al177/esp_hat/esp_hat.png

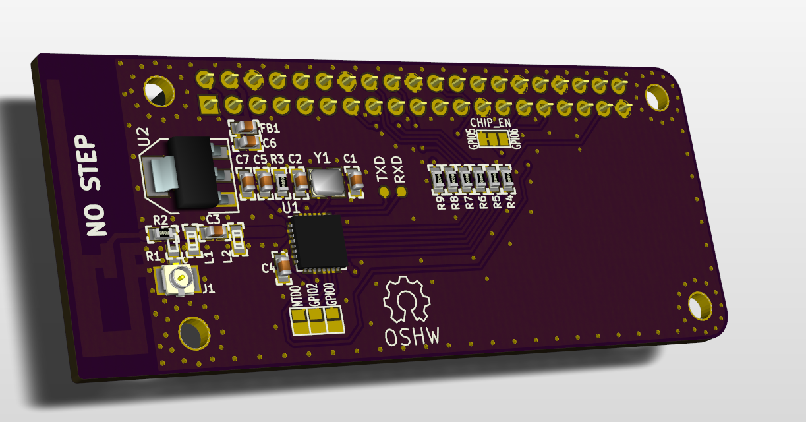
esp_hat.png
