al177/esp_hat/README.md

Attributions:
http://github.com/mcuos/kicad-lib - various footprints
https://github.com/StefanHamminga/SH_Antennas.pretty - antenna
