al177/esp_hat/esp_hat.pdf

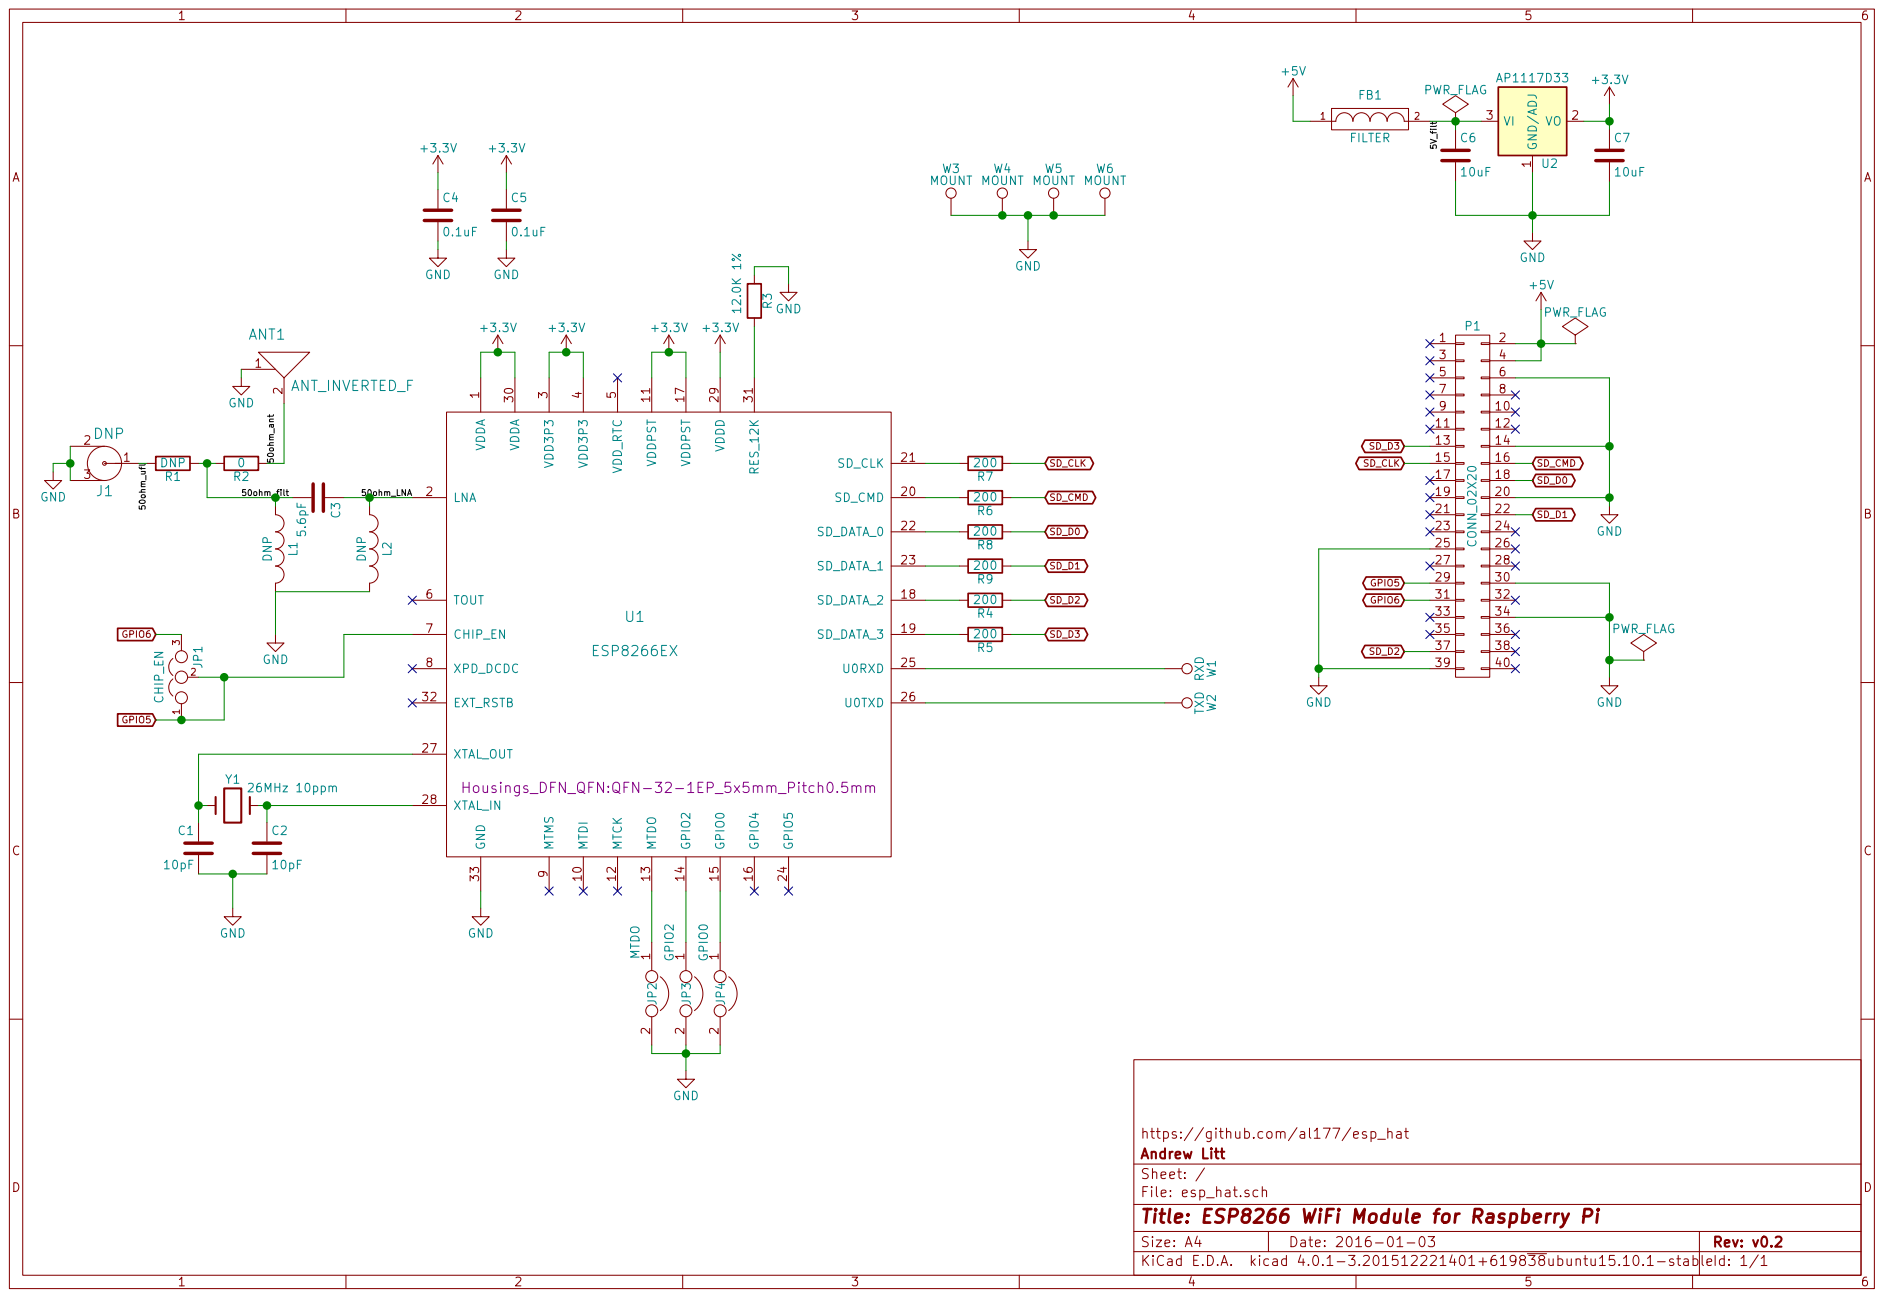
[picture p2: page 1]

9 MTDI 10 SD_CMD 20 VDDA 30 VDDPST 11 SD_CLK 21 RES_12K 31 MTCK 12 SD_DATA_0 22 EXT_RSTB 32 MTDO 13 SD_DATA_1 23 GND 33 GPIO2 14 GPIO5 24 GPIO0 15 U0RXD 25 GPIO4 16 U0TXD 26 VDDPST 17 XTAL_OUT 27 SD_DATA_2 18 XTAL_IN 28 SD_DATA_3 19 VDDD 29 U1 ESP8266EX

File: esp_hat.sch Sheet: / Andrew Litt https://github.com/al177/esp_hat

Id: 1/1 Title: ESP8266 WiFi Module for Raspberry Pi
