al177/esp_hat/esp_hat.kicad_pcb

## KiCad design esp_hat.kicad_pcb (2016-01-04)

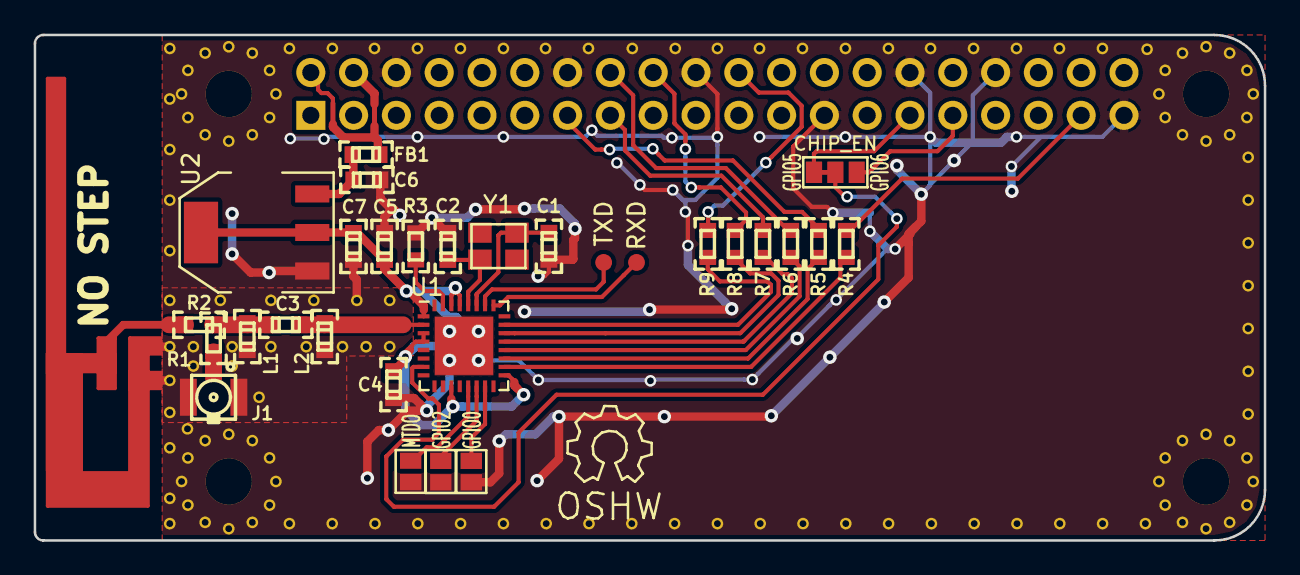
[picture p3: board esp_hat.kicad_pcb from above]

Board: 2 copper layers, 73.0 x 30.0 mm, 35 parts (1 on the bottom side), 30 nets.

Parts:
ANT1: ANT_INVERTED_F; TI_DN007_2.4GHz
C1, C2: 10pF; 0603(1608m)-CHIP-CAP
C3: 5.6pF; 0603(1608m)-CHIP-CAP
C4, C5: 0.1uF; 0603(1608m)-CHIP-CAP
C6, C7: 10uF; 0603(1608m)-CHIP-CAP
FB1: FILTER; 0603(1608m)-CHIP-CAP
J1: DNP; U.FL-COAX
JP1: CHIP_EN; GS3
JP2: MTDO; GS2
JP3: GPIO2; GS2
JP4: GPIO0; GS2
L1, L2: DNP; 0603(1608m)-CHIP-CAP
P1: CONN_02X20; Socket_Strip_Straight_2x20_pi
R1: DNP; 0603(1608m)-CHIP-RESISTOR
R2: 0; 0603(1608m)-CHIP-RESISTOR
R3: 12.0K 1%; 0603(1608m)-CHIP-RESISTOR
R4, R5, R6, R7, R8, R9: 200; 0603(1608m)-CHIP-RESISTOR
U1: ESP8266EX; QFN-32-1EP_5x5mm_Pitch0.5mm
U2: AP1117D33; SOT-223-REG_VOUTSLUG
W1: RXD; Measurement_Point_Round-SMD-Pad_Small
W2: TXD; Measurement_Point_Round-SMD-Pad_Small
W3, W4, W5, W6: MOUNT; NPTH_Hole_2_75mm
Y1: 26MHz 10ppm; crystal_FA238-TSX3225

Connections:
+3V3: C4.1, C5.1, C7.1, U1.1, U1.3, U1.4, U1.11, U1.17, U1.29, U1.30, U2.2
+5V: FB1.1, P1.2, P1.4
/5V_filt: C6.1, FB1.2, U2.3
/50ohm_LNA: C3.1, L2.1, U1.2
/50ohm_ant: ANT1.2, R2.1
/50ohm_filt: C3.2, L1.1, R1.1, R2.2
/50ohm_ufl: J1.1, R1.2
GND: ANT1.1, C1.2, C2.2, C4.2, C5.2, C6.2, C7.2, J1.2, J1.3, JP2.2, JP3.2, JP4.2, L1.2, L2.2, P1.6, P1.14, P1.20, P1.25, P1.30, P1.34, P1.39, R3.1, U1.33, U2.1, W3.1, W4.1, W5.1, W6.1
GPIO5: JP1.1, JP1.2, P1.29, U1.7
GPIO6: JP1.3, P1.31
unnamed: C1.1, U1.27, Y1.1
unnamed: C2.1, U1.28, Y1.2
unnamed: JP2.1, U1.13
unnamed: JP3.1, U1.14
unnamed: JP4.1, U1.15
unnamed: R3.2, U1.31
unnamed: R4.2, U1.18
unnamed: R5.2, U1.19
unnamed: R6.2, U1.20
unnamed: R7.2, U1.21
unnamed: R8.2, U1.22
unnamed: R9.2, U1.23
unnamed: U1.25, W1.1
unnamed: U1.26, W2.1
SD_CLK: P1.15, R7.1
SD_CMD: P1.16, R6.1
SD_D0: P1.18, R8.1
SD_D1: P1.22, R9.1
SD_D2: P1.37, R4.1
SD_D3: P1.13, R5.1
