al177/esp_hat/(commit log)

2015-12-11 Initial checkin
    [esp_hat.kicad_pcb, esp_hat.sch]
2015-12-12 Mostly done
    [esp_hat.kicad_pcb, esp_hat.sch]
2015-12-12 v0.1 to fab, moved text to back silk, changed license to CC-BY-SA
    [esp_hat-B.Cu.gbl, esp_hat-B.Mask.gbs, esp_hat-B.SilkS.gbo, esp_hat-Edge.Cuts.gm1, esp_hat-F.Cu.gtl, esp_hat-F.Mask.gts, esp_hat-F.SilkS.gto, esp_hat.drl]
2015-12-12 Update gerbers with paste file for stencils
    [esp_hat-B.Cu.gbl, esp_hat-B.Mask.gbs, esp_hat-B.SilkS.gbo, esp_hat-Edge.Cuts.gm1, esp_hat-F.Cu.gtl, esp_hat-F.Mask.gts, esp_hat-F.Paste.gtp, esp_hat-F.SilkS.gto]
2015-12-12 Add PDF of the schematic
    [esp_hat.sch]
2016-01-01 commit v0.2 changes, remove v0.1 fab files
    [esp_hat-B.Cu.gbl, esp_hat-B.Mask.gbs, esp_hat-B.SilkS.gbo, esp_hat-Edge.Cuts.gm1, esp_hat-F.Cu.gtl, esp_hat-F.Mask.gts, esp_hat-F.Paste.gtp, esp_hat-F.SilkS.gto]
2016-01-01 v0.2 fab files
    [esp_hat-B.Cu.gbl, esp_hat-B.Mask.gbs, esp_hat-B.SilkS.gbo, esp_hat-Edge.Cuts.gm1, esp_hat-F.Cu.gtl, esp_hat-F.Mask.gts, esp_hat-F.SilkS.gto, esp_hat.drl]
2016-01-01 Add schematic PDF for v0.2
2016-01-01 Add GPIO5/GPIO6 select pad, fix no-connects, remove paste on option pads
    [esp_hat-B.Cu.gbl, esp_hat-B.Mask.gbs, esp_hat-B.SilkS.gbo, esp_hat-Edge.Cuts.gm1, esp_hat-F.Cu.gtl, esp_hat-F.Paste.gtp, esp_hat-F.SilkS.gto, esp_hat.drl]
2016-01-01 Change CH_PD name to CHIP_EN
    [esp_hat-B.Cu.gbl, esp_hat-B.Mask.gbs, esp_hat-B.SilkS.gbo, esp_hat-Edge.Cuts.gm1, esp_hat-F.Cu.gtl, esp_hat-F.Mask.gts, esp_hat-F.Paste.gtp, esp_hat-F.SilkS.gto]
2016-01-04 Add part# parameters, clean up refs, set attributes for proper mfg
    [esp_hat-B.Cu.gbl, esp_hat-B.Mask.gbs, esp_hat-B.SilkS.gbo, esp_hat-Edge.Cuts.gm1, esp_hat-F.Cu.gtl, esp_hat-F.Mask.gts, esp_hat-F.Paste.gtp, esp_hat-F.SilkS.gto]
